lochej/WBTC/src/wbtc_manager/NodeRED/README.md

# WBTC NodeRED

## NodeRED Install

If this is not already done, install NodeRED with an internet connection using the following command:

```
#Install NodeRED
bash <(curl -sL https://raw.githubusercontent.com/node-red/linux-installers/master/deb/update-nodejs-and-nodered)
```

## Importing the NodeRED flow

Here you have the NodeRED [flows.json](flows.json) to import into you should import into your node red dashboard using the **import** menu.

Make sure to have imported all of the programs before you try interacting with the NodeRED website.

In fact, you will need **timecircuitctl** and **fluxcapacitorctl** processes to be accessible on order to use the website modules.
