lochej/WBTC/(commit log)

2019-12-05 Modified README of framebuffer_brightness
2019-12-17 fixed interrupt for GPIOs in Qsys and regenerated fpga binaries
2019-12-18 Added gitignore files to filter version control
2020-01-14 Added LED fully-on trigger when powering down the system
2020-01-31 Added wiring diagram for the TCD and FC
